dstn-m/Overdrive_Guitar_Pedal/Board_screenshot.PNG

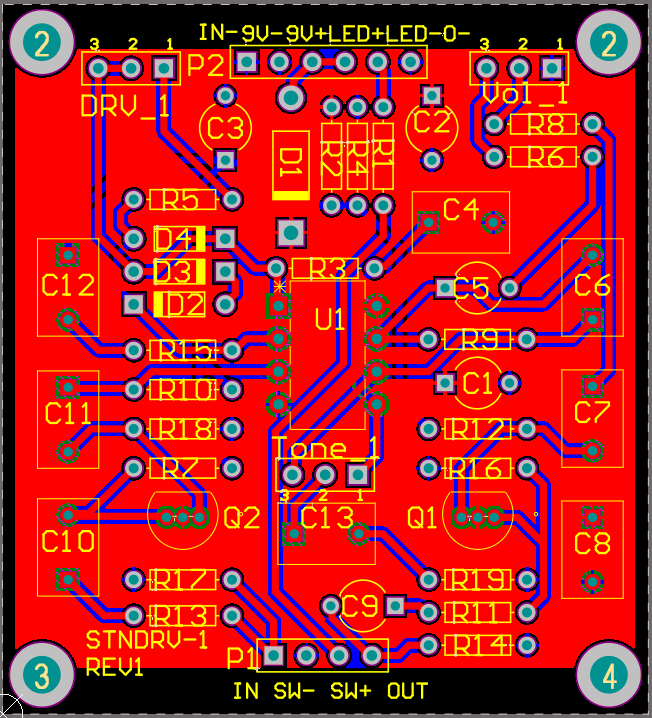
Board_screenshot.PNG
