dstn-m/Overdrive_Guitar_Pedal/SD-1_Spice_Schematic.jpg

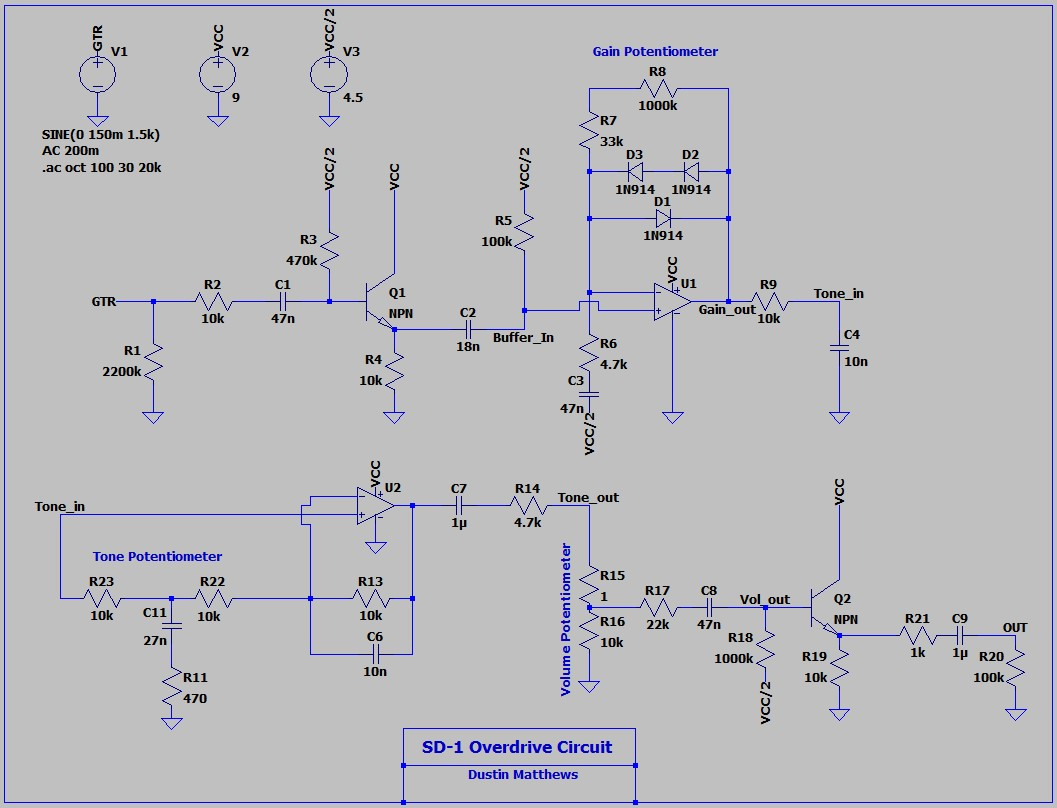
SD-1_Spice_Schematic.jpg
