dstn-m/Overdrive_Guitar_Pedal/SD-1_Altium_Schematic.pdf

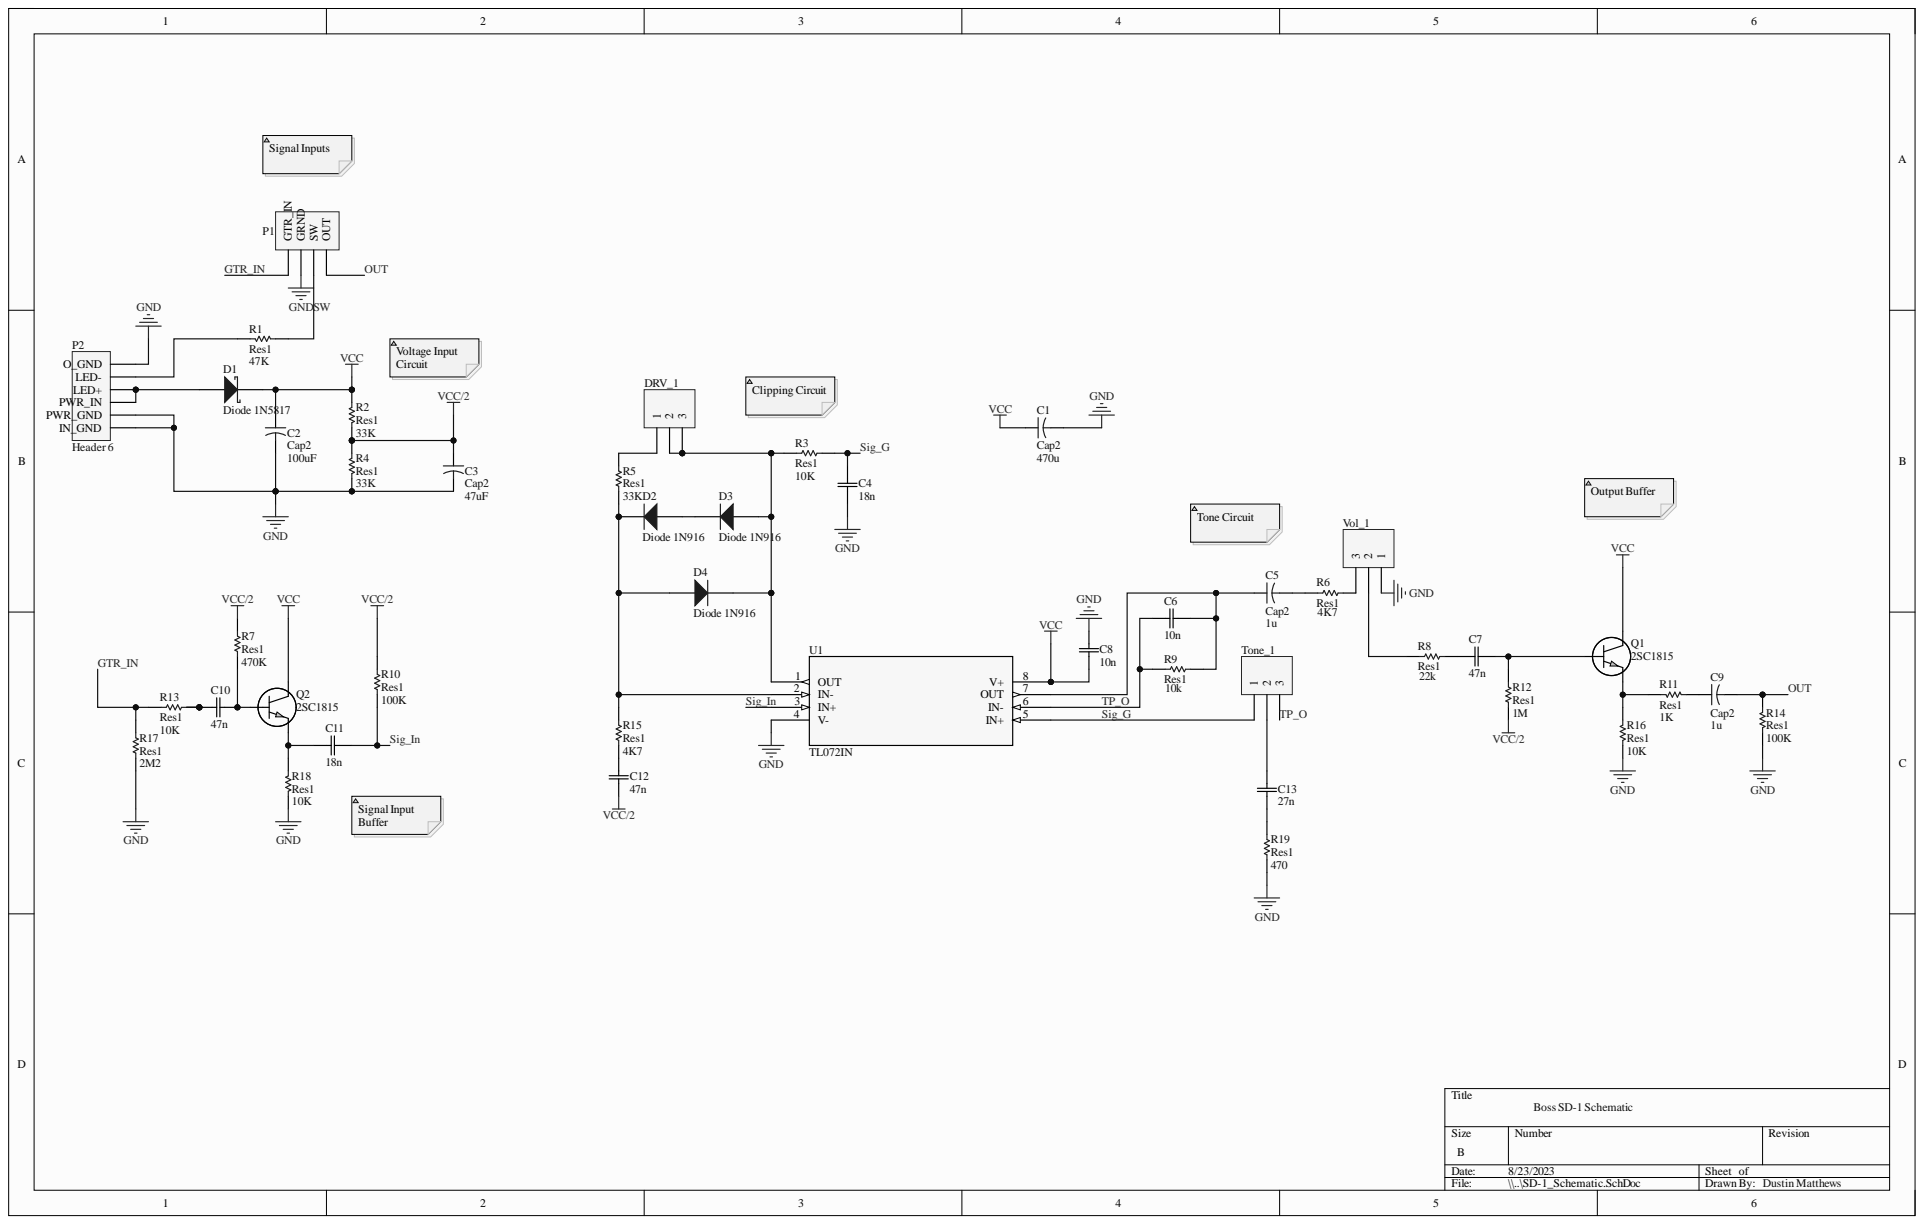
[picture p3: page 1]

Sig_I | n 3 | 6 | TP_O

4 | | 5 Sig_ G

Si z e | Num b er | Revi s i on

e : 8/23/ 20 2 3 | Sheet of
Fi l e : \\..\SD -1_Schemat ic.Sc hDo c | D rawn By: Dus t in Mat t hew s
