dstn-m/Overdrive_Guitar_Pedal/SD-1_Tone_Circuit.asc

C1: cap; 10n
C2: cap; 27n
C3: cap; 10n
C4: cap; 27n
C5: cap; 18n
C6: cap; 10n
C7: cap; 1µ
C11: cap; 27n
R1: res; 10k
R2: res; 20k
R3: res; 100k
R4: res; 470
R5: res; 10k
R6: res; 100k
R7: res; 20k
R8: res; 470
R9: res; 100k
R10: res; 10k
R11: res; 470
R12: res; 10k
R13: res; 10k
R14: res; 4.7k
R15: res; 1
R22: res; 10k
R23: res; 10k
U1: UniversalOpamp2
U2: UniversalOpamp2
U3: UniversalOpamp2
V1: voltage; SINE(0 1 10000); AC 1
V2: voltage; 9
V3: voltage; 4.5
Named nets: 0, GTR, VCC, Tone_mid, Tone_min, Tone_max, Prefilter, Filter_out
.ac dec 1000 2 20k
LPF
HPF
Active Filter Variations
