dstn-m/Overdrive_Guitar_Pedal/SD-1_Schem.asc

C1: cap; 47n
C2: cap; 18n
C3: cap; 47n
C4: cap; 10n
C6: cap; 10n
C7: cap; 1µ
C8: cap; 47n
C9: cap; 1µ
C11: cap; 27n
D1: diode; 1N914
D2: diode; 1N914
D3: diode; 1N914
Q1: npn
Q2: npn
R1: res; 2200k
R2: res; 10k
R3: res; 470k
R4: res; 10k
R5: res; 100k
R6: res; 4.7k
R7: res; 33k
R8: res; 1000k
R9: res; 10k
R11: res; 470
R13: res; 10k
R14: res; 4.7k
R15: res; 1
R16: res; 10k
R17: res; 22k
R18: res; 1000k
R19: res; 10k
R20: res; 100k
R21: res; 1k
R22: res; 10k
R23: res; 10k
U1: UniversalOpamp2
U2: UniversalOpamp2
V1: voltage; SINE(0 150m 1.5k); AC 200m
V2: voltage; 9
V3: voltage; 4.5
Named nets: 0, GTR, VCC, VCC/2, Buffer_In, Gain_out, Tone_in, OUT, Tone_out, Vol_out
.ac oct 100 30 20k
Gain Potentiometer
Tone Potentiometer
Volume Potentiometer
Dustin Matthews
SD-1 Overdrive Circuit
