dstn-m/Overdrive_Guitar_Pedal/(commit log)

2023-08-23 Initial commit
    LTSpice file and Altium schematic.
2023-08-28 Updated Schematics and Simulation File
2023-10-01 Report upload
    added additional spice file for analyzing the filter sections
